YoussefMiriXX/Militech-Project/README.md

At the forefront of technological innovation and the continual evolution of warfare machines, the
Militech robot appears to be a plausible solution for the future of modern warfare. Equipped with
four formidable tracks enabling all-terrain mobility, this robot is specifically designed to meet crucial strategic needs on the battlefield.
