YoussefMiriXX/Militech-Project/Youssef Miri/Rapport (Français)/Rapport séance 13.md

# <p align="center"><ins> Rapport Séance 13
##### 20 Mars 2024
### <ins>Résumé:
Au cours de cette séance, j'ai entamé la conception de la tourelle après avoir réalisé les tests sur le schéma de référence déjà établi.

#### <ins>1- Découpe laser d'une nouvelle planche:

Il suffit d'un dessin basique en Inkscape pour découper une planche de 35x25 cm qui servira de support pour les engrenages et l'étage supérieur de notre automate Militech.
Il s'agit d'une planche en bois.

#### <ins>2- Découpe laser des engrenages:

Suite à de nombreuses expériences, j'ai découvert qu'un engrenage de 10 cm de diamètre avec 10 dents est parfait pour être utilisé comme engrenage principal. Son centre a un diamètre de 4.450 mm, ce qui garantit un contact optimal avec l'axe du moteur pas-à-pas Nema17.

### <ins>3- Fixer le moteur à la planche:

Le moteur vise principalement à faire tourner l'engrange avec 10 dents. Cependant, si le moteur n'était pas correctement fixé à la planche, celle-ci pourrait tourner avec l'engrenage, ce qui entraînerait un problème, ce qui justifie la nécessité de fixer le moteur.
Dans un premier temps, j'ai indiqué sur ma planche la position de l'engrenage ainsi que son centre. Ensuite, j'ai déterminé les emplacements précis de chaque trou du moteur.
Par la suite, j'ai employé une perceuse afin de percer le bois dans les endroits déjà indiqués. La bande de 6mm utilisée était plus large que le diamètre du trou à réaliser, ce qui facilite grandement la fixation du moteur ensuite.
La vis et la rondelle étaient utilisées pour fixer le moteur.

### <ins>Montage finale:
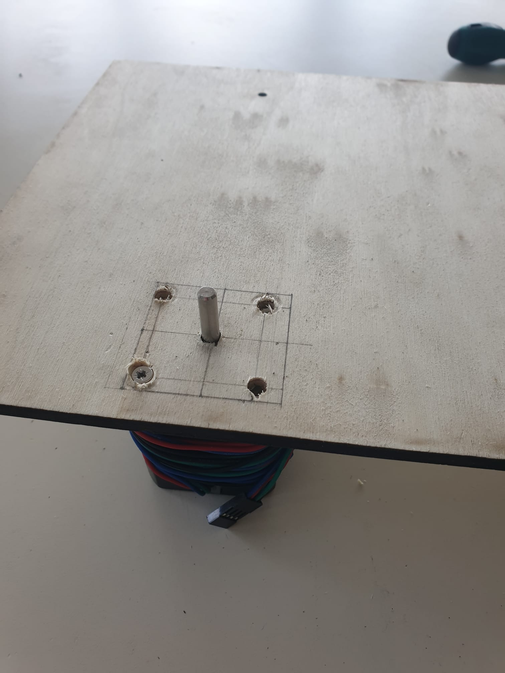
[picture p5: Youssef Miri/Images/montage1.jpg]
Montage1


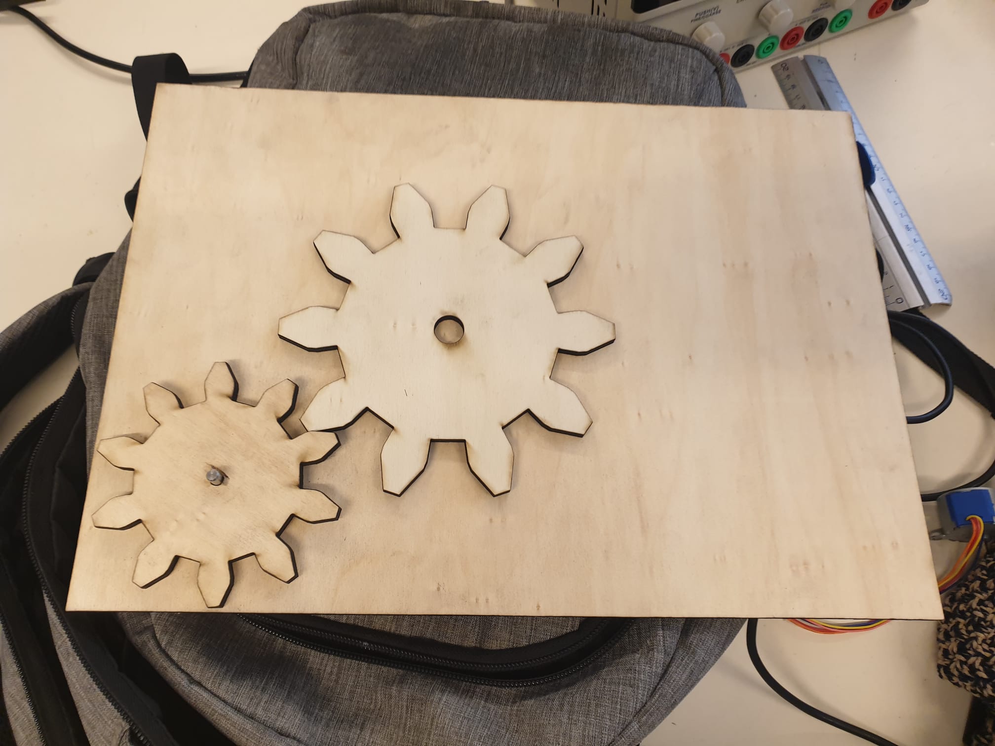
[picture p6: Youssef Miri/Images/montage2.jpg]
Grand engrenage à changer
