YoussefMiriXX/Militech-Project/RAPPORT Nicolas Consalvi/Compte rendu n°17 Consalvi Nicolas.pdf

Compte-Rendu n°17 Projet

I-Débugage du moteur avant gauche qui ne fonctionnait pas

Suite à de nombreux tests réalisés (vérification de code/ changement de pin en cas d'un dysfonctionnement de l'arduino mega....) en raison d'une panne du moteur de la chenille avant gauche du robot, il s'avérait que le problème venait de fils de connexions défectueux pour le pin 1 et 2 du moteur avant gauche. Ce problème a été résolu et le moteur tourne

II-Fin du travail sur le Bluetooth pour le contrôle de la motorisation.

A partir de l'application Arduino Bluetooth Control, j'ai réussi à pouvoir contrôler mon robot à partir de mon téléphone. Un changement d'application a résolu le problème de non détection du robot. En effet, l'application plus connue ''Bluetooth electronics'' n'était pas compatible avec mon téléphone. Avec la nouvelle application Arduino Bluetooth Control, le robot au nom de ''militech'' apparaissait alors dans la liste des appareils bluetooth.

Écriture du code Arduino:

Les instructions que l'on peut actuellement donner au robot à partir du téléphone sont: -avancer
-reculer
-tourner a gauche
-tourner à droite

Explication du code :Le téléphone est connecté au composant Bluetooth du robot et envoie des informations, notamment des lettres.
R pour Droite, L pour gauche , F pour avancer et B pour reculer. Il suffit alors d'assigner ces lettres à des touches virtuelles paramétrées sur l'application du téléphone : c'est un joystick virtuel. En appuyant sur ces touches, les lettres assignées à ces mêmes touches sont envoyées par l'application et réceptionnées par le module Bluetooth puis par l'arduino méga et ensuite traduites en instructions (avancer/reculer...).
Par exemple, en appuyant sur la flèche du haut : l'application envoie un F à la carte Arduino, qui est traduit en l'avancement du robot vers l'avant.

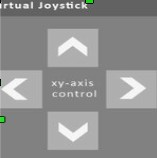
[picture p29: figure]

Joystick Virtuel

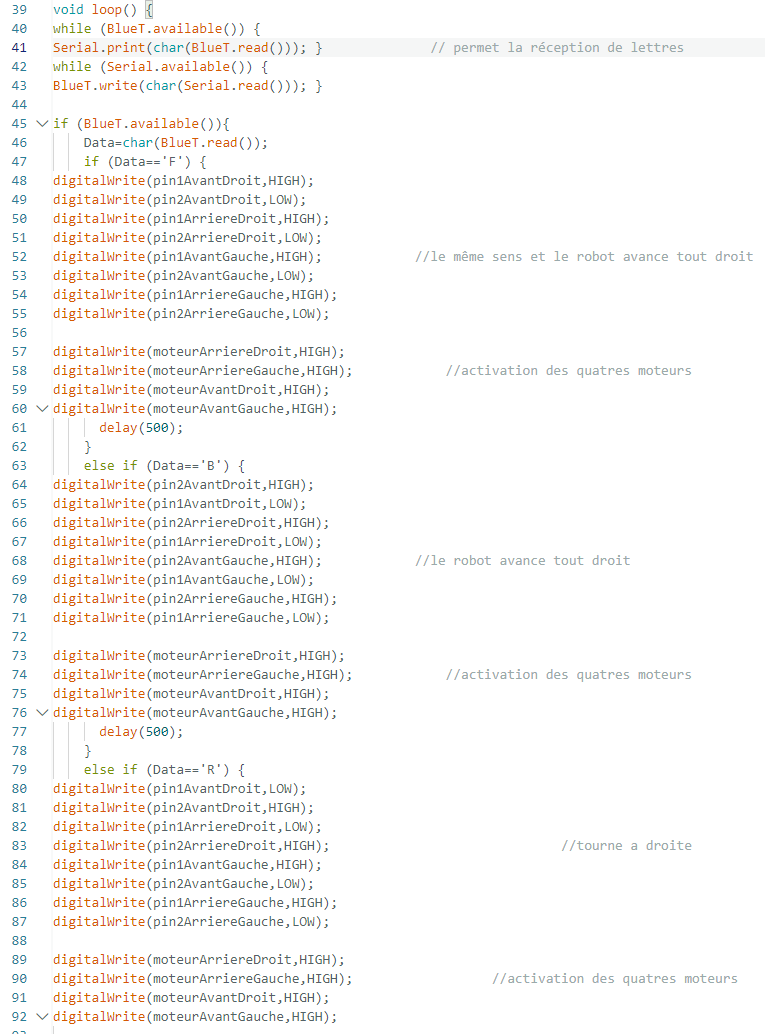
[picture p30: page 2]

Voici ci- joint une capture d'écran du code permettant la communication Bluetooth entre le Robot et le téléphone.

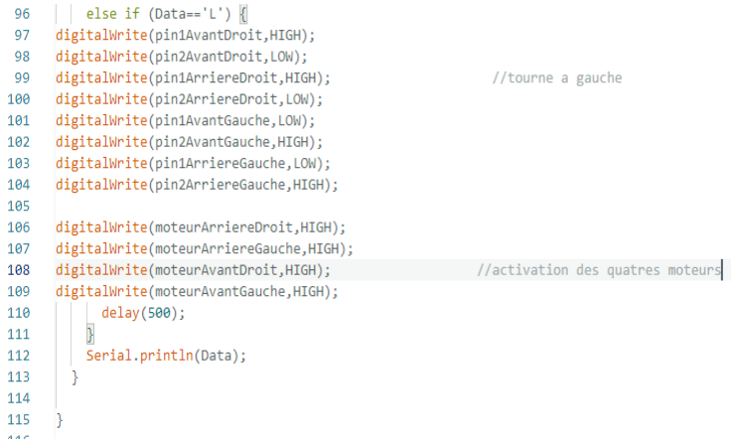
[picture p31: figure]

II- complétion du code de détection d'obstacle

Certaines distances ont été encore une fois modifiées dans le code de détection d'obstacle :
Le robot se heurtait encore parfois à des murs : il ne tournait pas assez tôt. Suite à plusieurs tests, j'ai alors pris la décision d'augmenter la distance à partir de laquelle notre robot allait tourner :

distance de détection d'obstacle des capteurs avant : passée de 40 à 60 cm
distance de détection d'obstacle des capteurs latéraux et diagonaux passée de 30 à 45 cm.

Le robot fonctionne alors parfaitement lorsqu'il rencontre des murs ou des objets larges. Toutefois, il peut lui arriver de ne pas détecter certains obstacles fins, comme des pieds de chaises.

Solution envisagée dans le futur: mettre un LIDAR pour faire une synergie de capteurs et améliorer la détection d'obstacle.
