YoussefMiriXX/Militech-Project/RAPPORT Nicolas Consalvi/Compte rendu n°8 Projet Consalvi Nicolas.pdf

### Compte-rendu Projet n°8

I-Test des quatre moteurs en simultané pour la détection d'obstacle

Suite à un manque de temps lié à une erreur de manipulation lors de la dernière séance, ce test n'a pas pu être réalisé la dernière fois.

On alimente les deux cartes Arduino Uno, ainsi que les pont en H.

La motorisation fonctionne et les moteurs s'activent tous et se désactivent lorsque les capteurs ultrasonores associés respectivement aux chenilles détectent un obstacle à moins de 10 cm.

Problème détecté: manque de précision lorsque un obstacle est détecté à l'avant et à l'arrière du robot (en marche arrière).

II-Début de la modélisation du châssis sur Fusion360

L'assemblage actuel du robot étant réalisé à partir de Ducktape (solution temporaire)

J'ai décidé de remplacer cette solution par une solution terminale et procéder par vissage d'une planche en bois sur le châssis en aluminium. Pour ce faire, j'ai mesuré à l'aide d'un pied à coulisse toutes les dimensions nécessaires à la modélisation que j'ai répertorié dans fusion.

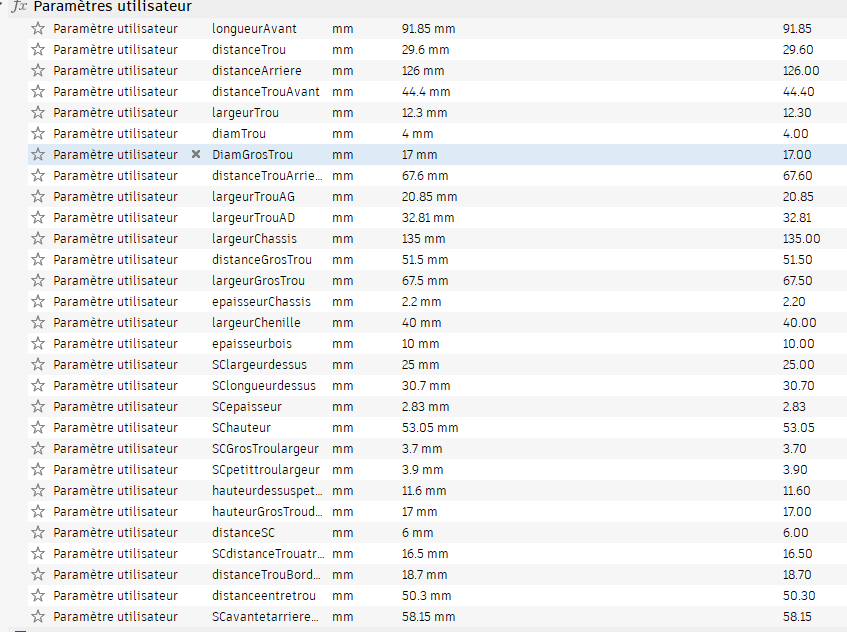
[picture p51: figure]

J'ai ensuite procédé à la modélisation du châssis ainsi que de la planche.

A) Esquisse de travail

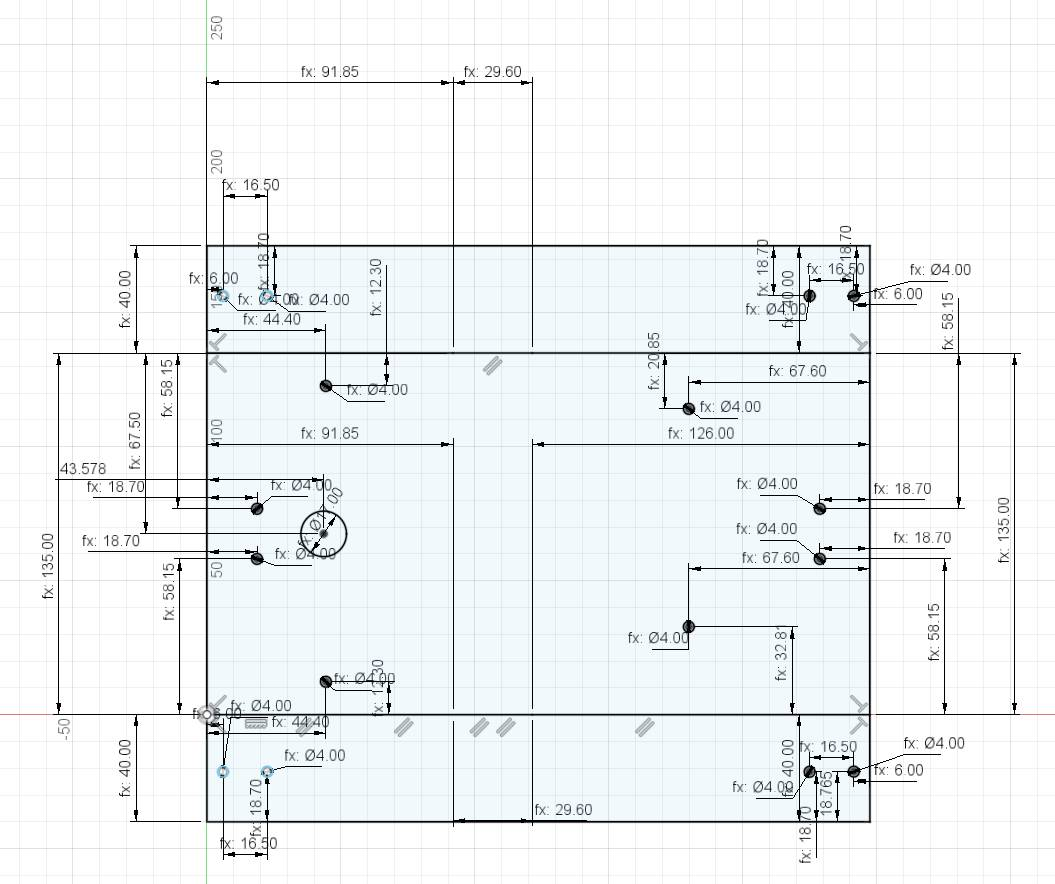
[picture p52: figure]

Sur cette esquisse de travail on s’intéressera particulièrement aux trous.

-Les paires de trous proches de l'extrémité, permettront de fixer les supports des capteurs ultrasonores nécessaires à la fixation des capteurs HC-SR04.

J'ai ajouté une paire de trous à l'avant du robot (côté gauche de l'esquisse) et à l'arrière du robot (côté droit de l'esquisse) : de base seuls les capteurs ultrasonores proche des chenilles ont été montés lors du test de motorisation, et je me suis rendu compte que l'évitement d'obstacle n'était pas assez précis sans des capteurs ultrasonores à l'avant et l'arrière du robot.

-Les quatre trous centraux seront utilisés afin de fixer la planche en bois sur le châssis par vissage.

-Le grand trou de diamètre 17mm permettra de faire passer certains fils.

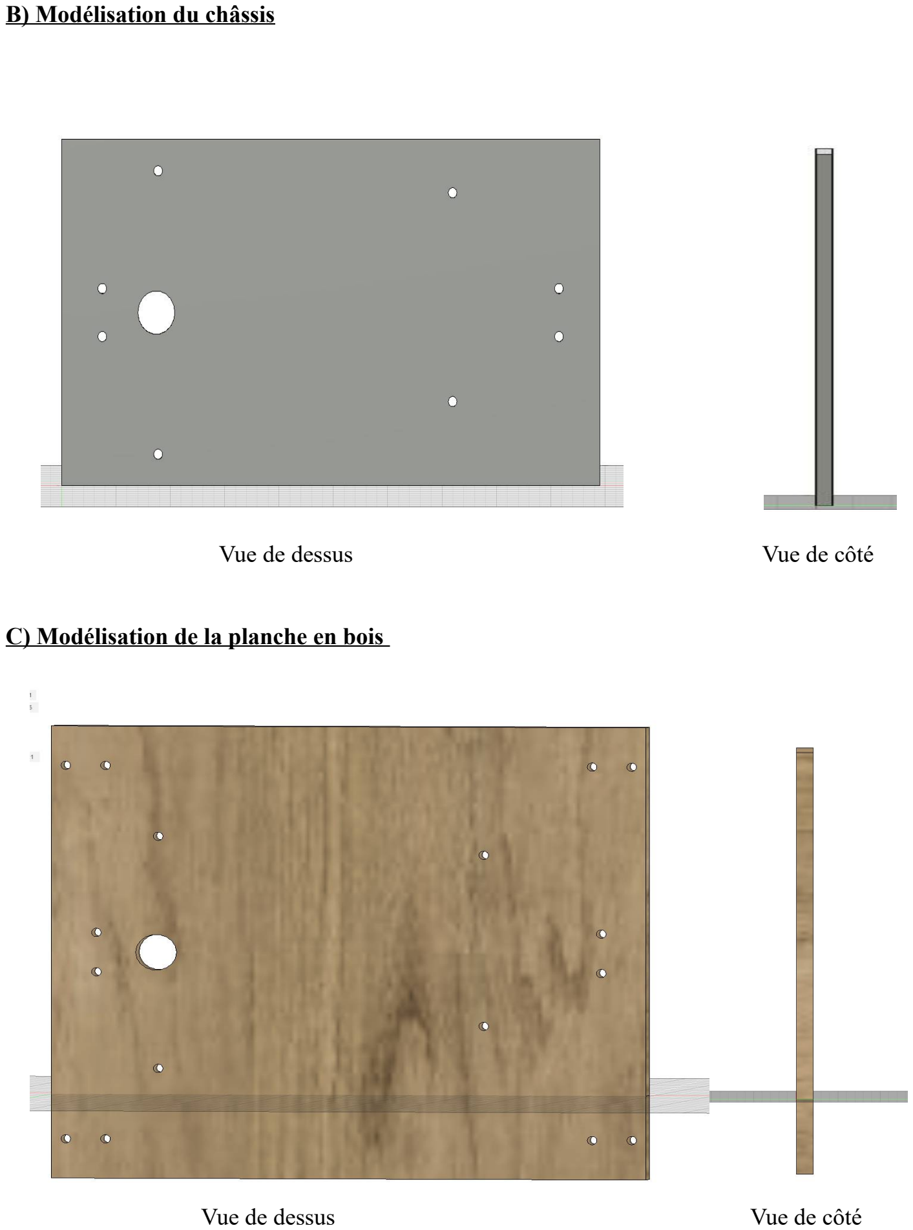
[picture p53: page 3]

B) Modélisation du châssis
Vue de dessus | Vue de côté
C) Modélisation de la planche en bois
Vue de dessus | Vue de côté

III- modélisation du support du capteur ultrasonore HC-SR04

Début de modélisation du support qu'on fixera à chaque paire de trous par vissage.

Modélisation du couvercle du support :

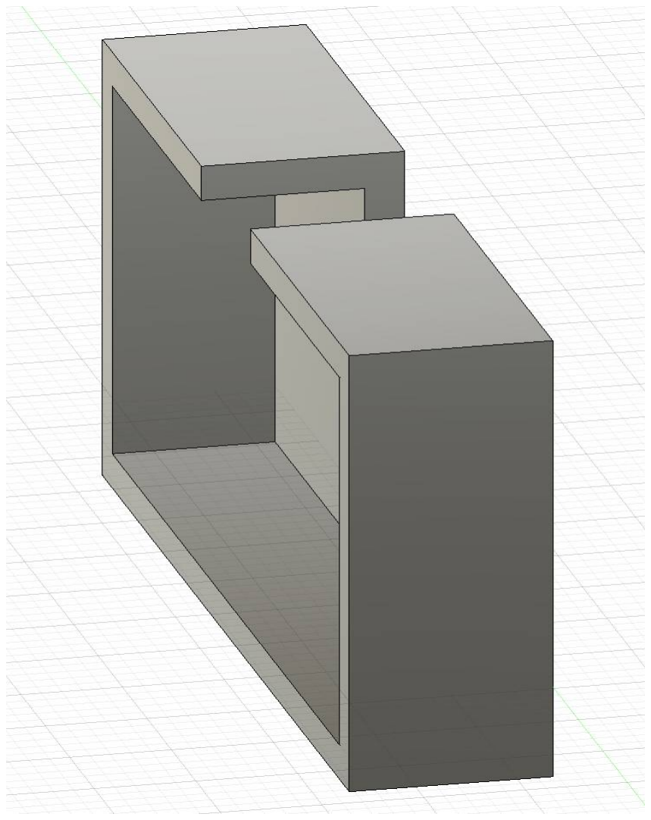
[picture p54: figure]
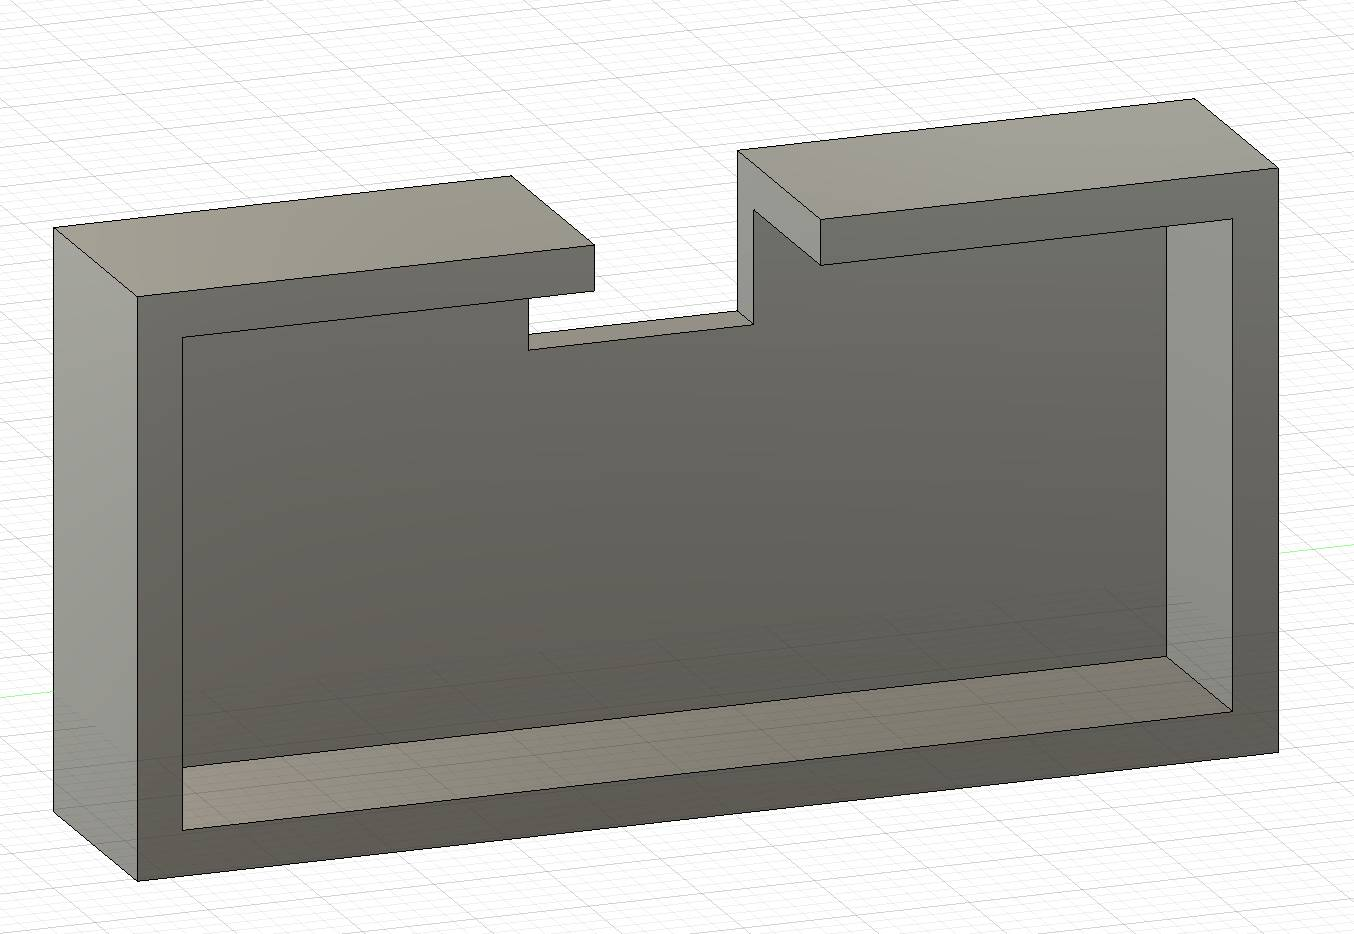
[picture p55: figure]

Vue de devant inclinée | Vue de côté inclinée

C'est le couvercle qui permettra de tenir l'arrière du capteur ultrasonore au support (le jeu étant très faible, les frottement assureront le maintien).

Objectif pour la prochaine séance : Lancer la découpe laser de la planche en bois et l'impression 3D du couvercle, continuer la modélisation du support. Remplacer les deux cartes Arduino uno par une carte Arduino méga pour plus de centralisation et un gain de place.
