YoussefMiriXX/Militech-Project/RAPPORT Nicolas Consalvi/Compte-Rendu 1 Projet Consalvi Nicolas(1)(1)[1].pdf

Compte-Rendu Projet 1 Consalvi Nicolas

Objectif : Démarrer la programmation des moteurs et de la détection d'obstacle

En attente de la livraison de notre châssis composés de 4 moteurs 12V CC, on réalise les branchements qu'on réalisera sur nos 4 moteurs à partir du moteur fourni pour actionner notre tourelle (moteur CC).

Pour ce faire on doit déjà s’assurer du fait que nos 6 capteurs ultrasons pour la détection d'obstacle placés sur notre robot militaire fonctionnent correctement, c'est à dire qu'ils nous renvoient la bonne distance à un obstacle:

I-Détection d'obstacle

La programmation du code permettant de donner la distance entre un capteur ultrasonore et un obstacle est donné ici : celui-ci nous permettra de donner une condition d'activation ou de désactivation des moteurs en fonction d'une distance minimale donnée entre le capteur ultrasonore et l'obstacle.

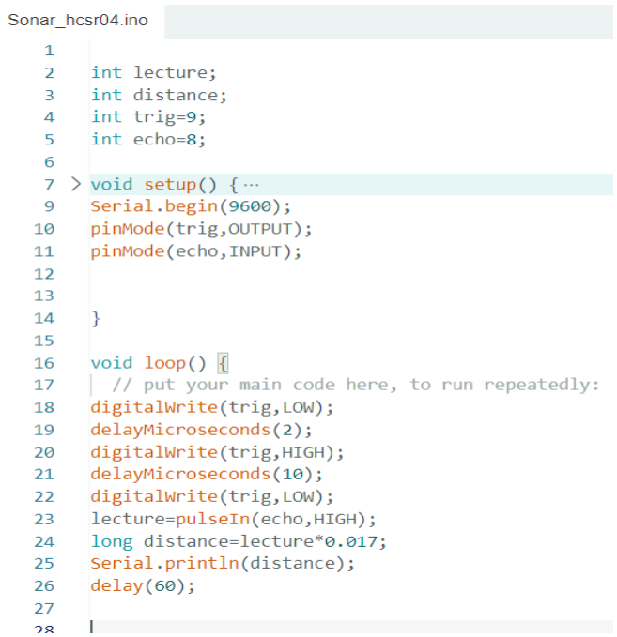
[picture p64: figure]

Le branchement réalisé pour le montage est le suivant : le programme nous renvoie la distance entre le détecteur d'obstacle et l'objet détecté jusqu'à une distance d'environ 5 mètres.

Le programme a été testé précédemment en cours et fonctionne.

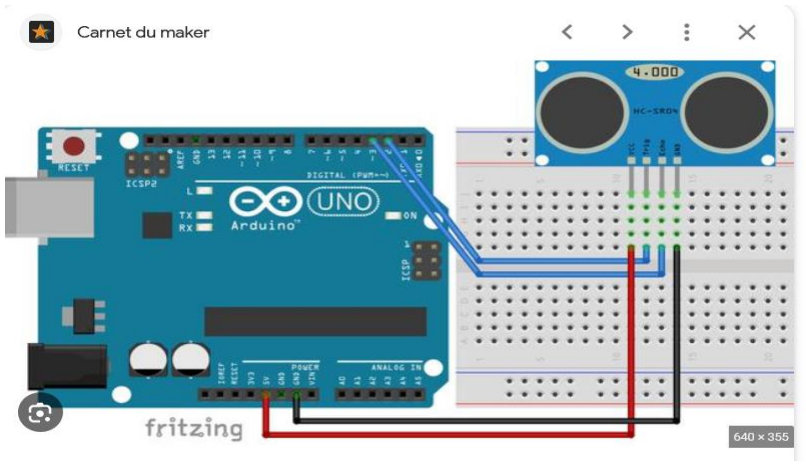
[picture p65: figure]

II-Programmation d'un moteur sur Arduino

Avec le kit Moteur + Carte de Contrôle initialement destiné à la rotation de notre tourelle, nous avons fait des recherches dans le but de faire fonctionner ce moteur.

D'une part j'ai téléchargé puis analysé la datasheet de la carte de contrôle du moteur fourni avec, ce qui nous a permis de brancher correctement le moteur et de le faire fonctionner tout en faisant varier sa vitesse à l'aide d'un potentiomètre.

Voir vidéo dans le github.

Une nouvelle problématique m'est venue à l'esprit lors du fonctionnement du moteur CC destiné à la rotation de la tourelle :

Comment changer le sens de rotation du moteur sans avoir à inverser les fils connectés au moteur ? (utilité pour passer de la marche avant à la marche arrière ou encore pour faire tourner la tourelle)

Pour ce faire, on doit se servir d'un pont en H :

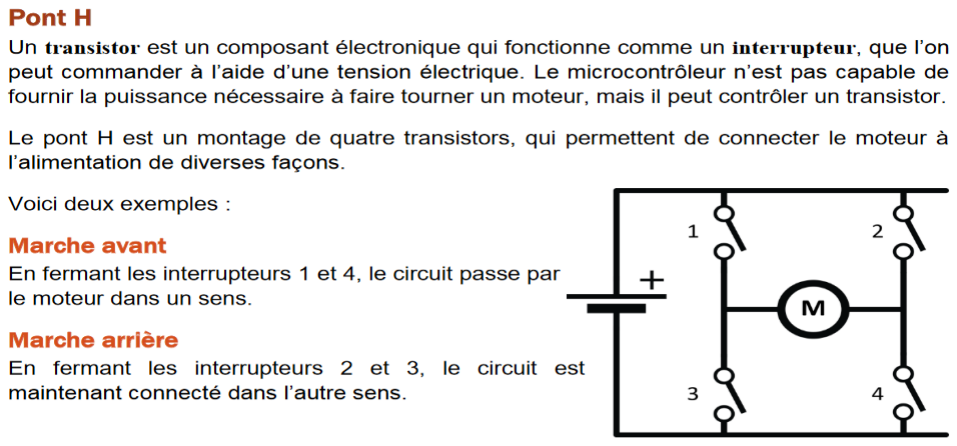
[picture p66: figure]

A partir du pont en H donné destiné à la carte arduino UNO, donné en cours, nommé Cytron MD10C, j'ai téléchargé et analysé sa datasheet, dans le but de construire un circuit sur Arduino capable de changer le sens de rotation du moteur.

Après analyse,de la datasheet c'est le le pin nommé DIR du pont en H qui en fonction de s'il reçoit une entrée HIGH ou LOW, va faire tourner le moteur dans le sens horaire ou anti-horaire.

On place également un potentiomètre dans le but de faire varier la vitesse de rotation du moteur.

Montage réalisé:

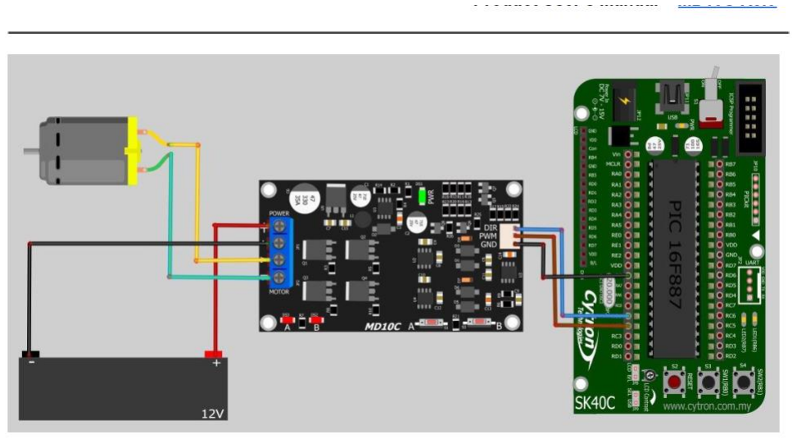
[picture p67: figure]

Voici le code Arduino permettant de réaliser ce qui a été expliqué précédemment.

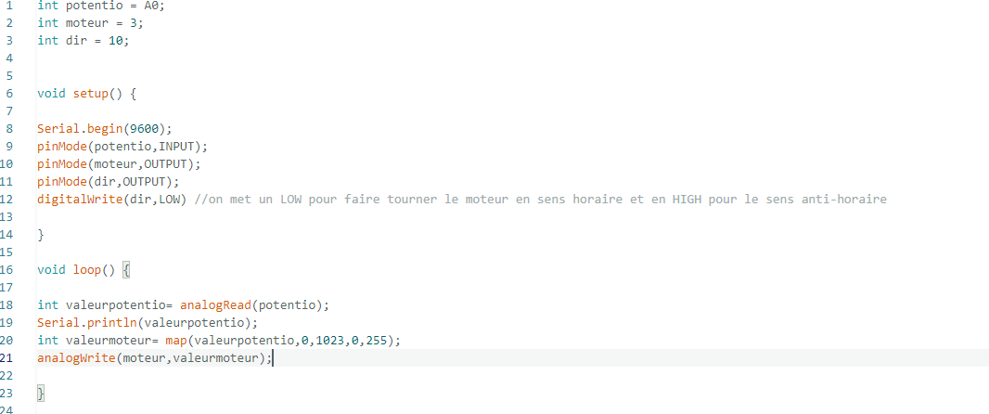
[picture p68: figure]

III-soudure

Pendant cette séance, nous avons rencontré un premier problème : une des broches de notre moteur (entrée +) s'est cassée, on a donc réalisé une soudure à l'étain en reliant les bornes + et – du moteur à des fils arduino (sans succès : le moteur ne tournait pas, la connexion à la borne lors de la soudure devait être mal réalisée).

On a alors emprunté un châssis d'un projet précédent qui possédait un moteur 12V CC dans le but de tester notre programme.
Voir Vidéo dans le github.

IV- Objectifs pour l'étape suivante :

Créer un programme capable d'activer un moteurs ou de le désactiver après avoir détecté un obstacle.
