YoussefMiriXX/Militech-Project/Youssef Miri/Rapport (Français)/Rapport séance 14.md

# <p align="center"><ins> Rapport Séance 14

##### 29 Mars 2024

### <ins>Résumé:
Pendant cette séance, j'ai rencontré plusieurs problèmes avec les engrenages.
Donc c'était nécéssaire de remodéliser de nouveaux des engrenages.

### <ins> Étape 1: Modéliser les engrenages

En utilisant Inkscape ou même fusion 360, le nombre de dents d'un engrenage est celui qui décide son diamètre .C-à-d que pour créer un engrange supposons de 30 cm de diamètre, il faut avoir 30 dents ni moins ni plus.

#### <ins>Engrenage Finale:

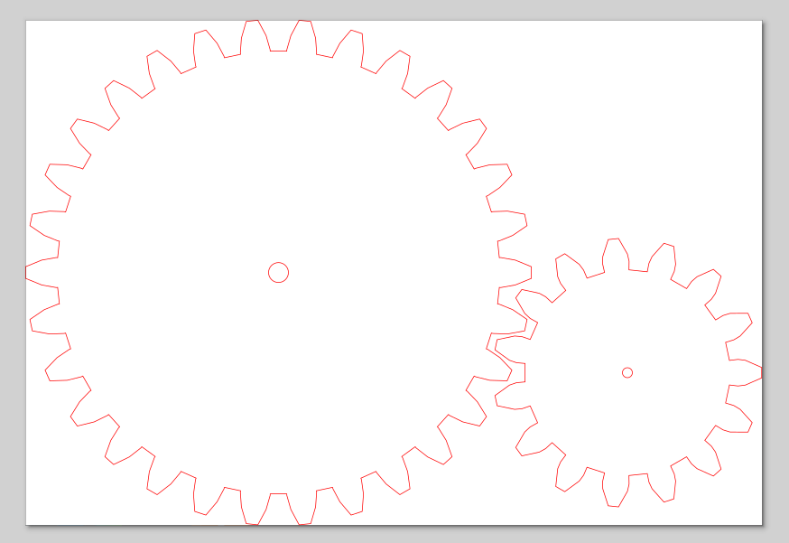
[picture p70: Youssef Miri/Images/engrenage finale.png]


### <ins> Étape 2: Faire le montage.

Dans cette étape j'ai juste monté mes engrenages sur une planche en bois faite par découpe laser.

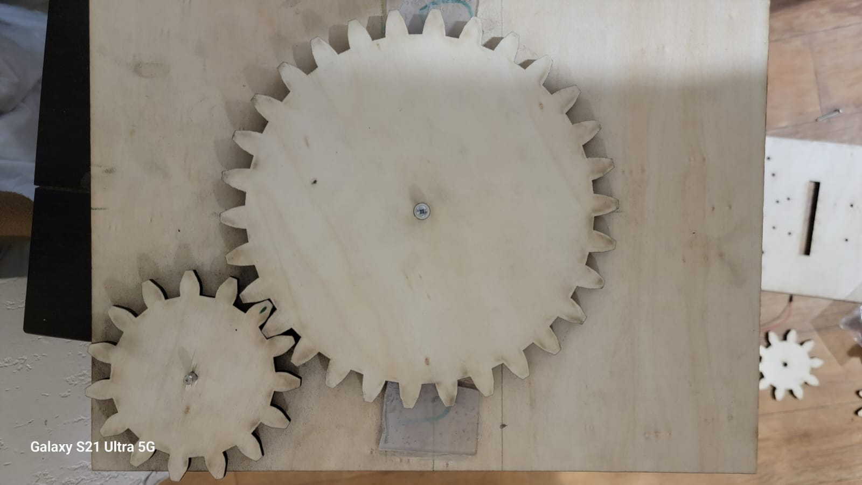
[picture p71: Youssef Miri/Images/planche+engrenage.jpg]


### <ins> Étape 3: Problème de frottement.

Un problème de frottement existe quand les 2 engrenages tournent. Donc pour limiter ce problème, j'ai décidé de coller deux pièces de plexiglass sur la planche en bois.

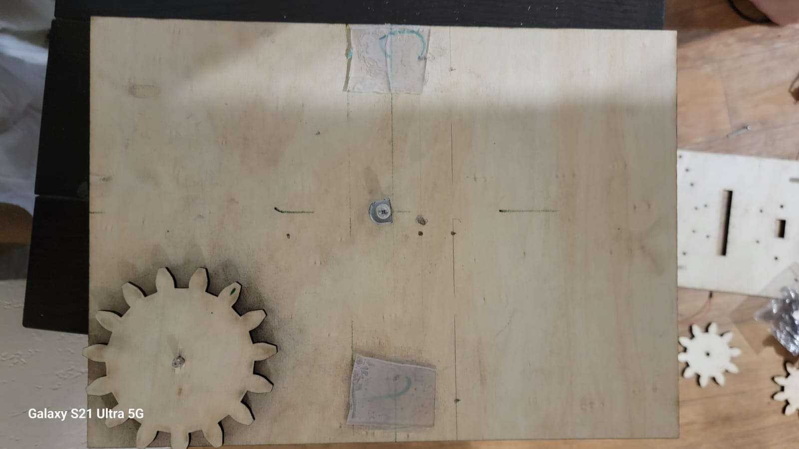
[picture p72: Youssef Miri/Images/frottement.jpg]
