YoussefMiriXX/Militech-Project/RAPPORT Nicolas Consalvi/Compte rendu n°9 Consalvi Nicolas.pdf

### Compte-Rendu de séance n°9

I-Suite du travail sur la modélisation du châssis et de la planche en bois

Après réflexion la solution la plus adaptée pour l’aménagement des pièces de notre robot (pont en H/carte méga) est de réaliser un double étage à partir d'entretoise : Le premier étage sur lequel on vissera les composants nécéssaires au robot, un deuxième étage supérieur sur lequel on posera le canon électromagnétique.

On vissera la carte méga ainsi que les deux ponts en H L293D sur la planche en bois actuellement en train d'être modélisée.

J'ai mesuré les dimensions de la carté méga, et ajouté les trous correspondant pour pouvoir la visser sur la planche en bois.

J'ai également modifié certains paramètres pour rapprocher les trous des supports des capteurs ultrasonores du bord de la planche.

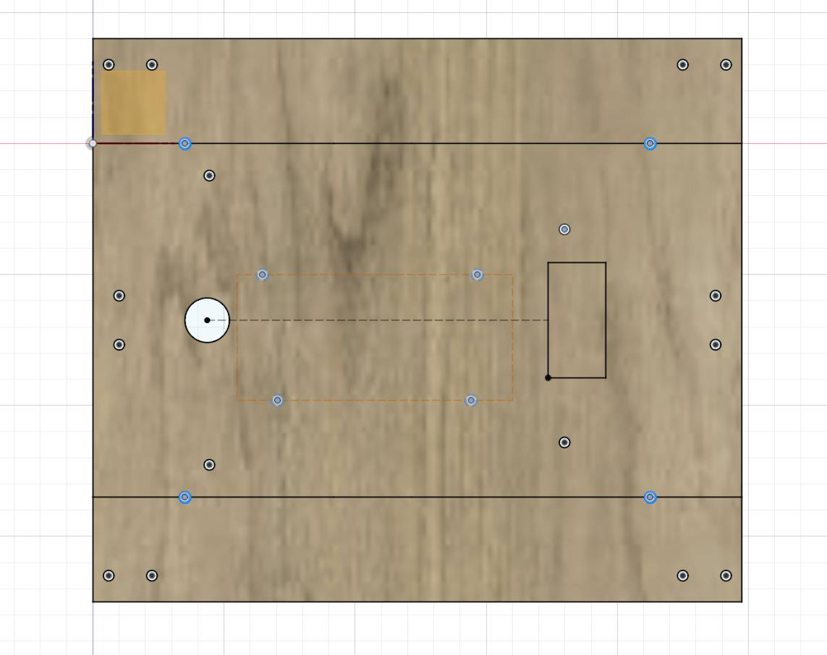
[picture p81: figure]

-Les quattre trous centraux en bleu sur les pointillets oranges correspondent aux trous pour visser la carte arduino méga.
-Les quattre trous bleus formant un rectangle sur les lignes noires vont être les trous pour pouvoir poser un deuxième étage à partir d'entretoises.
-Un nouveau rectangle a été crée pour laisser passer les fils (trou rectangulaire dans le châssis).

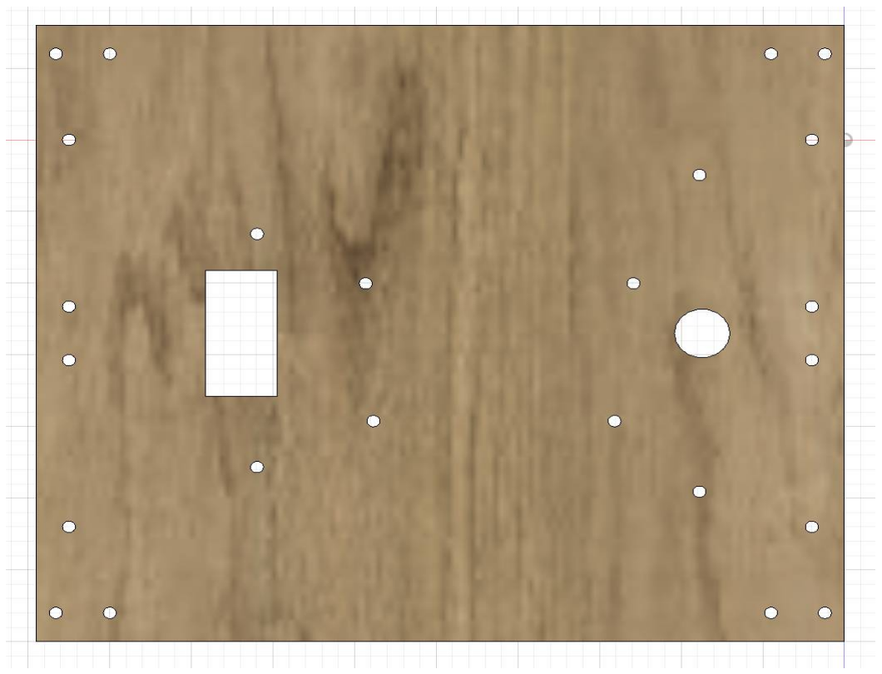
[picture p82: figure]

Planche en bois avec trous, vue du Dessus

II- Suite du Travail sur la modélisation du support du capteur ultrasonore HC-SR04

Répertoire des mesures réalisées pour pouvoir réaliser la modélisation

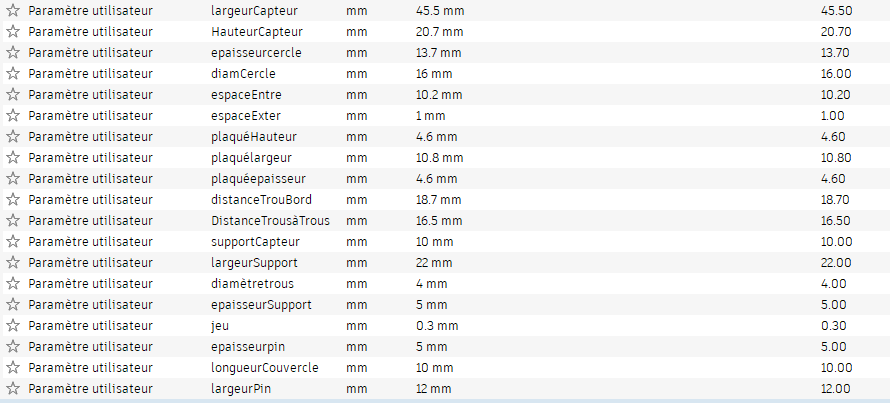
[picture p83: figure]

J'ai continué la modélisation du capteur commencée à partir de la semaine précédente. Le design du couvercle à été ajusté pour mieux s'adapter aux dimensions du support.

Composant 1: Support du capteur

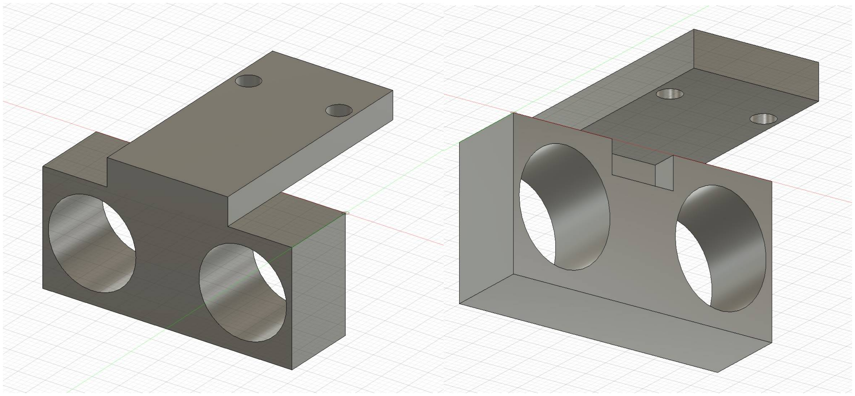
[picture p84: figure]

Composant 2: Couvercle

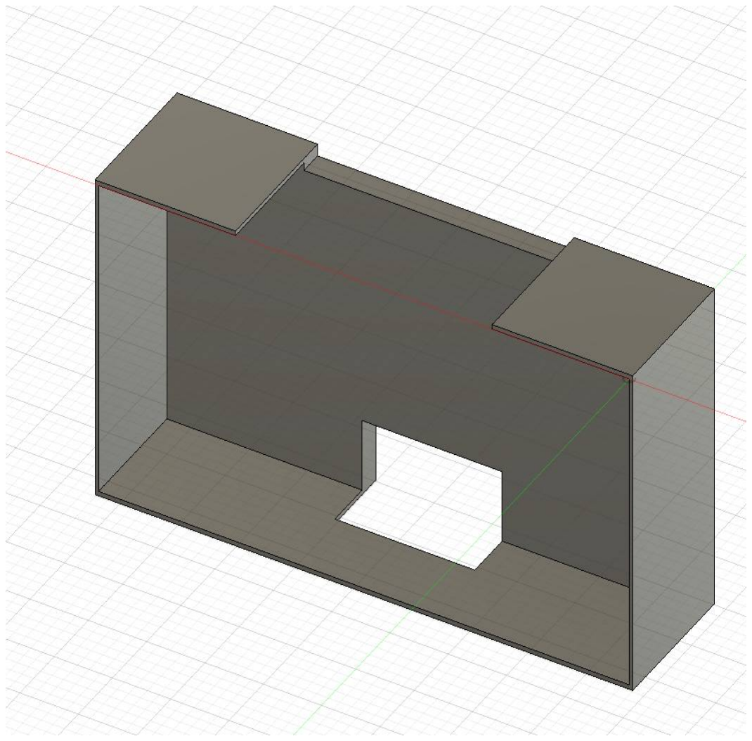
[picture p85: figure]
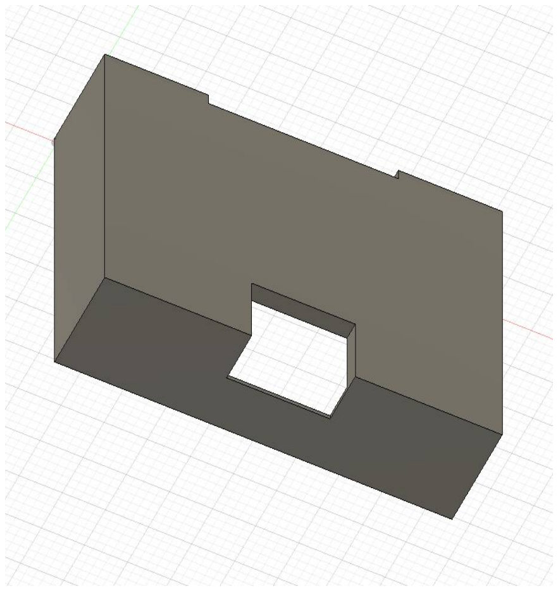
[picture p86: figure]

On ajoutera le couvercle à l'arrirère du support pour pouvoir faire tenir le capteur ultrasonore à l'intérieur du Support, la fixation se fait par frottement.

La réalisation du support est presque terminée, il reste à revoir le design et les tolérances. La première impression 3D lancée m'a permis de voir que les trous centraux des capteurs sont un peu trop espacés.

Objectif pour la prochaine séance:

-Continuer le travail de modélisation du support du capteur (redéfinition de mesures) et intégration des autres composants (mesure des dimensions du pont en H et modélisation des trous).
-Découpe laser et Test des mesures réalisées/Fixation de la planche au chassis.
-Impressions 3D des supports ultrasonores ajustés.
