YoussefMiriXX/Militech-Project/RAPPORT Nicolas Consalvi/Compte-rendu n°4 Projet Consalvi Nicolas.pdf

Compte-rendu n°4 Projet

Objectif de la séance : Pouvoir faire en sorte que chaque moteur de l'arrière du châssis s'active à partir du capteur à ultrason associé respectivement. Si cette étape est achevée alors la motorisation du train avant du robot sera similaire (on branchera deux moteurs et deux capteurs ultrasons sur une nouvelle carte arduino uno (deux au total pour la motorisation)).

Lors de la séance précédente, les capteurs à ultrasons renvoyaient une valeur nulle ce qui pouvait supposer deux choses :
-Soit le code était incomplet
-Soit le capteur était défectueux ou les branchements incorerects.

I-Debugage des capteurs

J'ai commencé par tester chacun des capteurs (arrière-gauche et arrière-droit) avec un code nous permettant d'obtenir la distance en cm entre le capteur respectif et un obstacle quelconque en utilisant uniquement des fonctions non bloquantes (millis et micros tout en supprimant tous les delays()).

Voici le code correspondant.

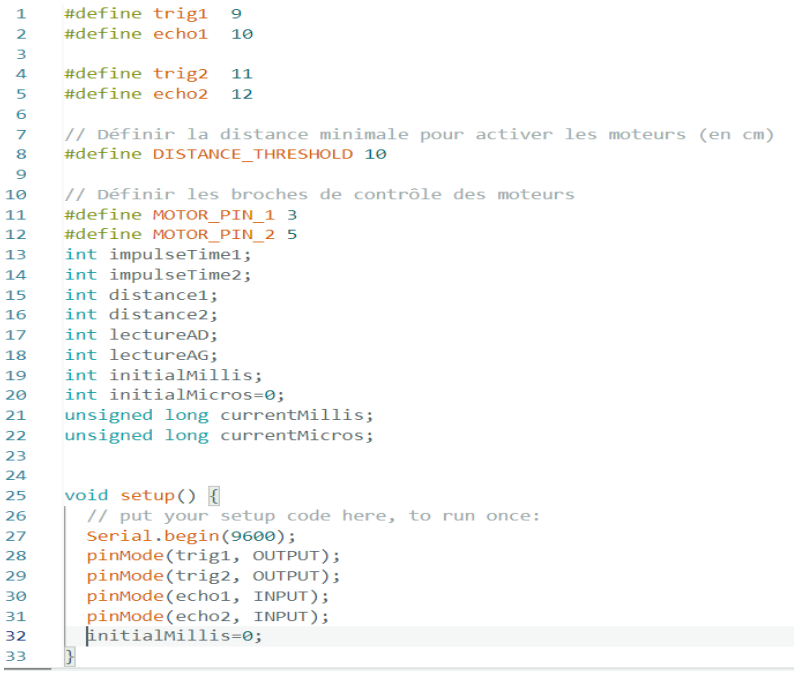
[picture p87: figure]
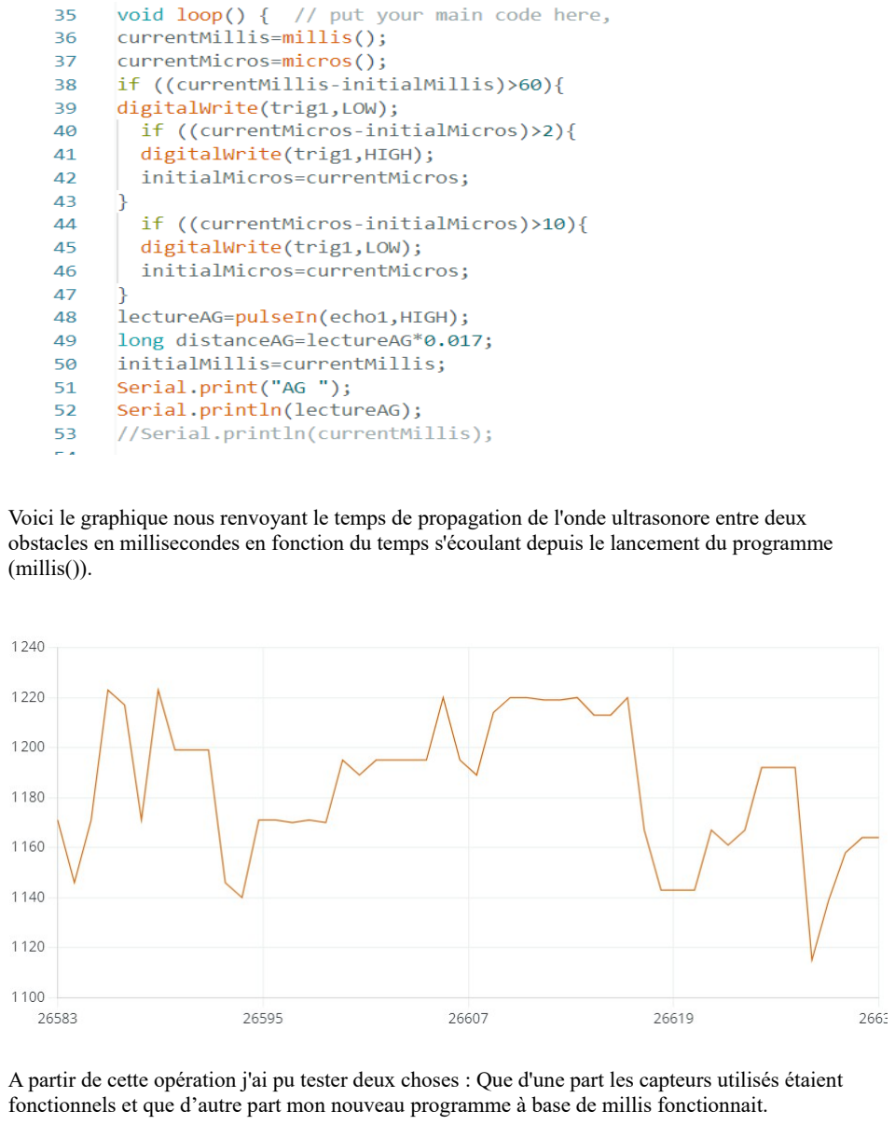
[picture p88: page 2]

Voici le graphique nous renvoyant le temps de propagation de l'onde ultrasonore entre deux obstacles en millisecondes en fonction du temps s'écoulant depuis le lancement du programme (millis()).

A partir de cette opération j'ai pu tester deux choses : Que d'une part les capteurs utilisés étaient fonctionnels et que d’autre part mon nouveau programme à base de millis fonctionnait.

J'ai modifié mon programme pour pouvoir cette fois ci supporter deux capteurs à ultrasons : la seule partie du programme modifiée (hors désignation de nouvelles variables) est la boucle loop().

En voici une capture d'écran :

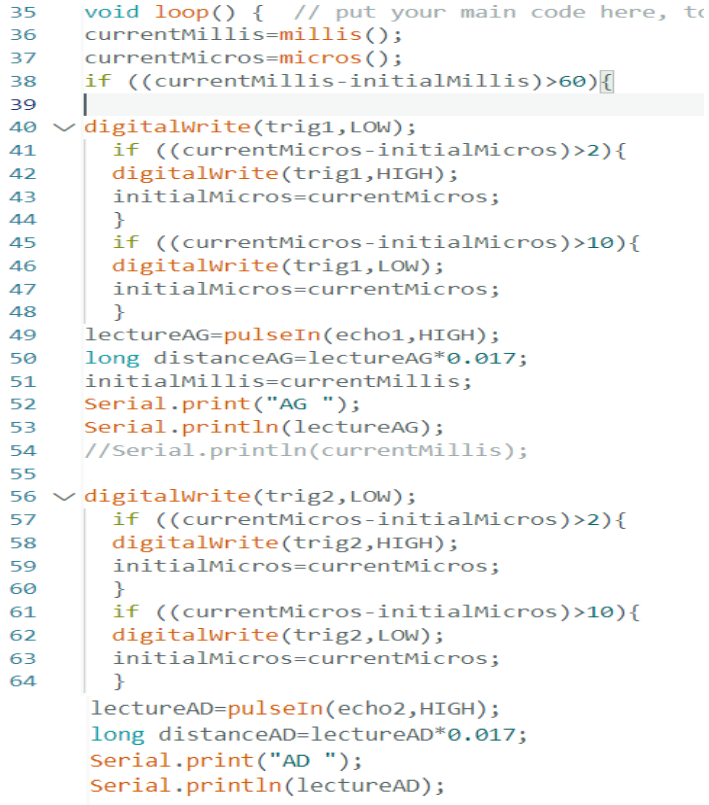
[picture p89: figure]

Les lignes 40 à 53 représentent l'activation du capteur arrière-gauche
Les lignes 56 à 68 représentent l'activation du capteur arrière-droit

Voici un échantillon des valeurs renvoyées par les deux capteurs à ultrasons représentant la distance en cm séparant le capteur respectif d'un obstacle (AG pour le capteur associé au moteur arrière gauche et AD pour le capteur associé au moteur arrière droit)

Les capteurs ultrasons et le programme à base de millis étant fonctionnels, on ajoute les moteurs.

II-Activation des moteurs en fonction des capteurs d'obstacles

Le nouveau bout de code correspondant au moteur est ajouté dans loop(), on ne modifie pas le reste du code (en dehors de l'ajout des nouvelles variables et des nouveaux pins utilisés)

Voici l'ajout de code :

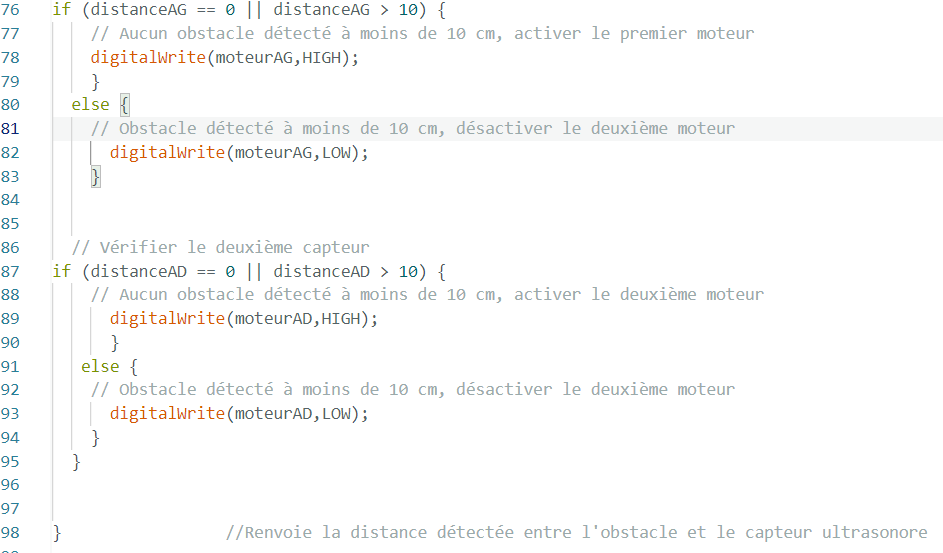
[picture p90: figure]

Le code fonctionne parfaitement et répond aux attentes : Les deux capteurs et les moteurs fonctionnent de manière simultanée : il n'y a plus de blocage dû aux delay().

Voici une vidéo résumant l'activation et la désactivation des moteurs en fonction de la distance détectée par les capteurs d'obstacles: (voir dans le github)

III-Revissage/ remplacement de certaines vis et collage

Les boulons fixés au châssis ne tenaient pas après activation des moteurs (ils se dévissaient en permanence). Certaines n'étaient pas adaptées (vis trop courtes utilisées dû à un manque de vis dans le colis lors de la livraison en raison d'une fouille à la douane) et j'ai donc cherché de nouvelles vis au fablab pour pouvoir les remplacer. Après avoir simplement revissé plusieurs fois les boulons, j'ai décidé cette fois-ci de fixer ces derniers avec de la colle forte en tant que solution provisoire.
