YoussefMiriXX/Militech-Project/Youssef Miri/Images/hand.png

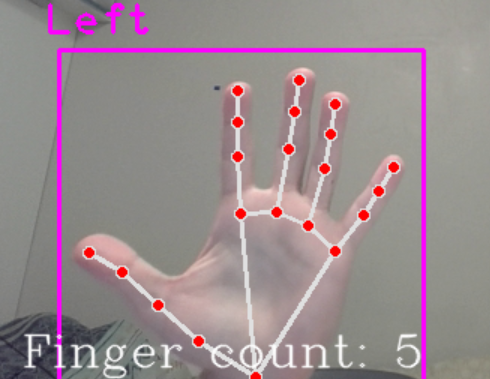
Youssef Miri/Images/hand.png
