YoussefMiriXX/Militech-Project/(commit log)

2023-11-21 changement de fichier
2023-11-22 ajout du rapport de nicolas
2024-01-17 ajouter les images
